JMonrealT/IVESDRIS/RENDER.png

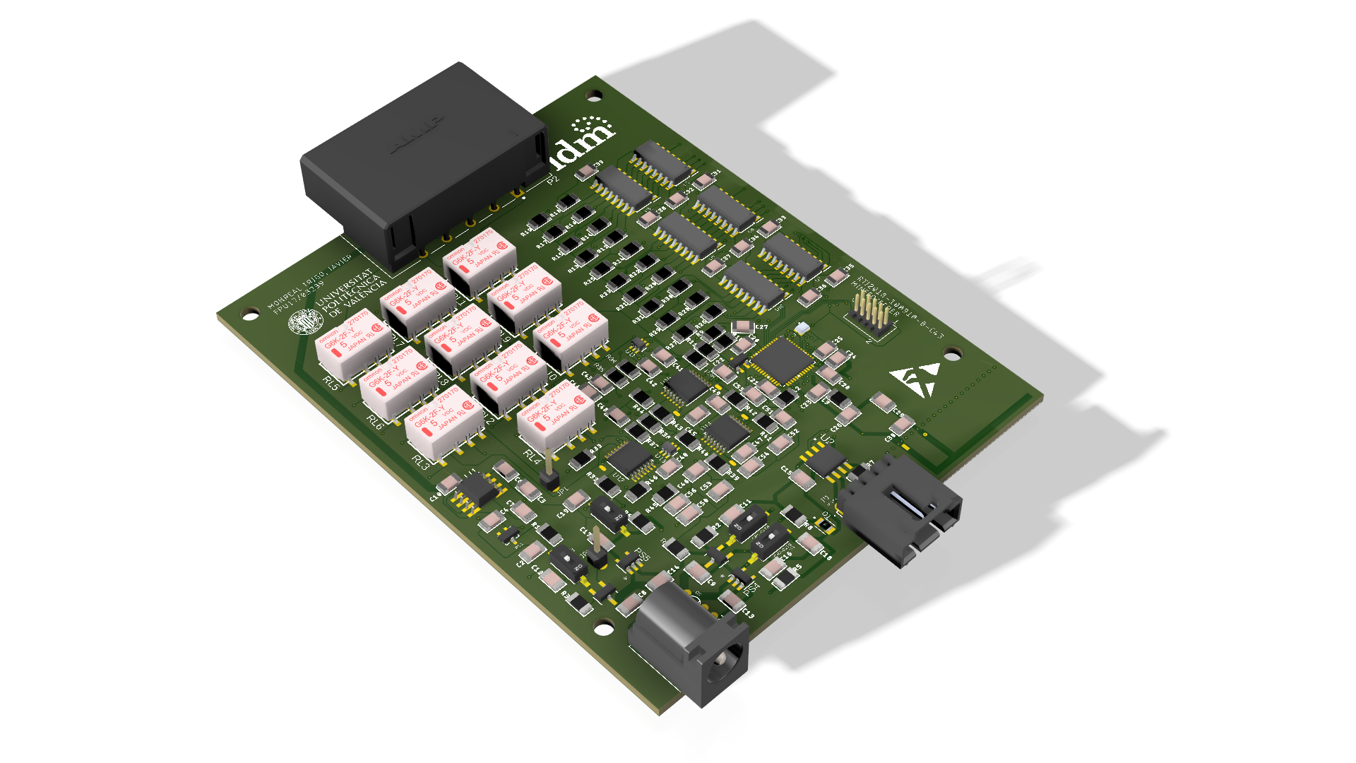
RENDER.png
