JMonrealT/IVESDRIS/Stimulator - Hardware/BoM IVEEDRIS-SCIR.xlsx

Components for ASSEMBLER Eurocircuits
Qty | Value | Device | Package | Parts | Description | DIGIKEY_PRICE-STOCK | HEIGHT | MANUFACTURER_NAME | MANUFACTURER_PART_NUMBER | SUPPLIER_PART_NUMBER
1 |  | ADR5043BKSZ-REEL7KS_3_ADI-M | KS_3_ADI-M | U4 |  |  |  | Analog Devices Inc | ADR5043BKSZ-REEL7
3 |  | CAP_CERAMIC0805 | 805 | C42, C43, C44 | Ceramic Capacitors
10 |  | G6KU-2F-Y | G6KU-2F-Y | RL1, RL2, RL3, RL4, RL5, RL6, RL7, RL8, RL9, RL10 |  | https://www.digikey.com/es/products/detail/omron-electronics-inc-emc-div/G6KU-2F-Y-DC5/1816071 |  | Omron Electronics Inc-EMC Div | G6KU-2F-Y DC5 | Z3303-ND
1 |  | RESISTOR0402 | 402 | R4 | Resistors
1 | 0.0051uH | INDUCTOR0805 | 805 | L3 | Inductors
4 | 0.1u | CAP_CERAMIC0805 | 805 | C22, C24, C25, C27 | Ceramic Capacitors
1 | 0.1uH | INDUCTOR0805 | 805 | L2 | Inductors
2 | 0.7p | CAP_CERAMIC0805 | 805 | C23, C26 | Ceramic Capacitors
1 | 1-316130-2 | 1-316130-2 | TE_1-316130-2 | P2 | CONN HDR 5POS R/A KEY-X 15GOLD | https://www.digikey.com/es/products/detail/te-connectivity-amp-connectors/1-316130-2/664364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 |  | TE Connectivity AMP Connectors | 1-316130-2 | A29616-ND
1 | 100k | RESISTOR1206 | 1206 | R34 | Resistors
17 | 100n | CAP_CERAMIC0805 | 805 | C2, C7, C15, C31, C33, C35, C37, C38, C39, C41, C46, C50, C51, C52, C53, C54, C55 | Ceramic Capacitors
3 | 10k | RESISTOR0805 | 805 | R1, R45, R46 | Resistors
8 | 10n | CAP_CERAMIC0805 | 805 | C4, C6, C10, C16, C17, C40, C45, C47 | Ceramic Capacitors
2 | 10p | CAP_CERAMIC0805 | 805 | C29, C30 | Ceramic Capacitors
4 | 10u | CAP_CERAMIC0805 | 805 | C3, C18, C19, C20 | Ceramic Capacitors
1 | 120 | RESISTOR0805 | 805 | R7 | Resistors
1 | 12k | RESISTOR1206 | 1206 | R36 | Resistors
1 | 12p | CAP_CERAMIC0805 | 805 | C28 | Ceramic Capacitors
2 | 18k | RESISTOR0805 | 805 | R39, R43 | Resistors
1 | 18k | RESISTOR0805 | 805 | R41 | Resistors
1 | 1k | RESISTOR1206 | 1206 | R35 | Resistors
2 | 1m | APSG160ELL102MH20S | CAP_ALUMINIUM | C1, C5 |  | https://www.digikey.com/es/products/detail/united-chemi-con/APSG160ELL102MH20S/5824534 |  | United Chemi-Con | APSG160ELL102MH20S | 565-4311-ND
12 | 1u | CAP_CERAMIC0805 | 805 | C8, C9, C11, C12, C13, C14, C21, C32, C34, C36, C48, C49 | Ceramic Capacitors
1 | 20k | RESISTOR0805 | 805 | R33 | Resistors
1 | 220 | RESISTOR0805 | 805 | R8 | Resistors
1 | 22p | CAP_CERAMIC0805 | 805 | C56 | Ceramic Capacitors
3 | 27k | RESISTOR0805 | 805 | R40, R42, R44 | Resistors
1 | 30k | RESISTOR0805 | 805 | R32 | Resistors
20 | 50 | RESISTOR0805 | 805 | R12, R13, R14, R15, R16, R17, R18, R19, R20, R21, R22, R23, R24, R25, R26, R27, R28, R29, R30, R31 | Resistors
3 | 74HCT238D | 74HCT238D | SOIC127P600X175-16N | U5, U6, U7 | 74HCT238D, Decoder, Demultiplexer HCT, 1-of-8 Non-Inverting 5V 16-Pin SOIC | https://www.digikey.com/es/products/detail/nexperia-usa-inc/74HCT238D652/1023079 | 1.75mm | Nexperia | 74HCT238D,652 | 1727-3389-ND
1 | 820 | RESISTOR0805 | 805 | R11 | Resistors
2 | ADG839 | ADG839 | SC70-6L | U11, U13 | Analog switch. | https://www.digikey.com/es/products/detail/analog-devices-inc/ADG839YKSZ-500RL7/995413 |  | Analog Devices Inc. | ADG839YKSZ-500RL7 | ADG839YKSZ-500RL7TR-ND
4 | CHS-01TB | CHS-01TB | CHS-01TB | S1, S2, S3, S4 |  | https://www.digikey.com/es/products/detail/nidec-copal-electronics/CHS-01TB/948315 |  | Nidec Copal Electronics | CHS-01TB | 563-1004-2-ND
1 | FTSH-105-XX-XX-D | FTSH-105-XX-XX-D | FTSH-105-XX-XX-D | J2 | 0.050X0.050" CL THROUGH HOLE TERMINAL STRIP ASSEMBLY,10 PINS." | https://www.digikey.com/es/products/detail/samtec-inc/FTSH-105-04-F-D/6678180 |  | Samtec | FTSH-105-04-F-D | SAM9443-ND
1 | LM4040DEM3-2.5_NOPB | LM4040DEM3-2.5_NOPB | SOT95P237X112-3N | PS1 |  | https://www.digikey.com/es/products/detail/texas-instruments/LM4040DEM3X-2-5-NOPB/367115 |  | Texas Instruments | LM4040DEM3X-2.5/NOPB | 296-LM4040DEM3X-2.5/NOPBTR-ND
2 | LT1761ES5-3.3TRPBF | LT1761ES5-3.3TRPBF | TSOT-23_S5 | PS4, PS5 |  | https://www.digikey.com/es/products/detail/analog-devices-inc/LT1761ES5-3-3-TRPBF/960258 |  | Linear Technologies | lt1761es5-3.3#trpbf | LT1761ES5-3.3#TRPBFTR-ND
1 | MAX3490ECSA+ | MAX3490ECSA+ | SOIC127P600X175-8N | U2 | Interface IC - transceivers Maxim Integrated MAX3490ECSA+ RS422, RS485 1/1 SOIC 8 N | https://www.digikey.com/es/products/detail/maxim-integrated/MAX3490ECSA-T/1703411 |  | Maxim Integrated | MAX3490ECSA+ | MAX3490ECSA+TTR-ND
2 | MCP1702 | MCP1702 | SOT23-A | PS2, PS3 |  | https://www.digikey.com/es/products/detail/microchip-technology/MCP1702T-2502E-CB/1098467 |  | Microchip Technology | MCP1702T-2502E/CB | MCP1702T-2502E/CBTR-ND
1 | MKW41Z512VHT4 | MKW41Z512VHT4 | LQFN48_7X7 | U3 |  | https://www.digikey.com/es/products/detail/nxp-usa-inc/MKW41Z512VHT4/6073454 |  | NXP | mkw41z512vht4 | MKW41Z512VHT4-ND
1 | MOLEX_SL70400_4-PIN | MOLEX_SL70400_4-PIN | MOLEX_SL70400_4-PIN | P1 |  | https://www.digikey.es/product-detail/es/molex/0705530038/WM4926-ND/313765 |  | Molex | 705530038 | WM4926-ND
3 | OPA4376PW | OPA4376PW | TSSOP14-NOTHERMALPAD | U12, U14, U15
1 | PJ-037A | PJ-037A | CUI_PJ-037A | J1 | 2.0 mm Center Pin, 2.5 A, Right Angle, Through Hole, Dc Power Jack Connector Check prices | https://www.digikey.es/product-detail/es/cui-devices/PJ-037A/CP-037A-ND/1644545 |  | CUI Devices | PJ-037A | CP-037A-ND
1 | SM0805UGC | SM0805UGC | LEDC2012X135N | D1 | LED; SMD; 0805; Ultra Green; 563nm; 10mcd; Water Clear Lens; 130 Deg Viewing Angle | https://www.digikey.es/product-detail/es/bivar-inc/SM0805UGC/492-1329-1-ND/2408561 |  | Bivar Inc. | SM0805UGC | 492-1329-1-ND
1 | TLV2462IDG4 | TLV2462IDG4 | SO8 | U1 |  | https://www.digikey.es/product-detail/es/texas-instruments/TLV2462AQDRQ1/296-17738-1-ND/716923 |  | Texas Instruments | TLV2462AQDRQ1 | 296-17738-1-ND
3 | ULN2003LVDR | ULN2003LVDR | SOIC127P600X175-16N | U8, U9, U10 | 7-Ch Relay, Inductive Sink Driver SOIC16 Texas Instruments ULN2003LVDR, 7-element NPN Darlington Transistor Array, 140 mA 8 V, 16-Pin SOIC | https://www.digikey.es/product-detail/es/texas-instruments/ULN2003LVDR/296-30403-1-ND/3283552 | 1.75mm | Texas Instruments | ULN2003LVDR | 296-30403-1-ND
1 | XRCGB32M000FBH50R0 | XRCGB32M000FBH50R0 | XRCGB32_F | Y1 | MURATA - XRCGB32M000FBH50R0 - CRYSTAL, 32MHZ, 10PF, SMD, 2MM X 1.6MM | https://www.digikey.es/product-detail/es/murata-electronics/XRCGB32M000FBH50R0/490-18345-1-ND/9959807 |  | Murata Electronics | XRCGB32M000FBH50R0 | 490-18345-1-ND
