JMonrealT/IVESDRIS/Stimulator - Enclosure/Ensamblaje.SLDASM

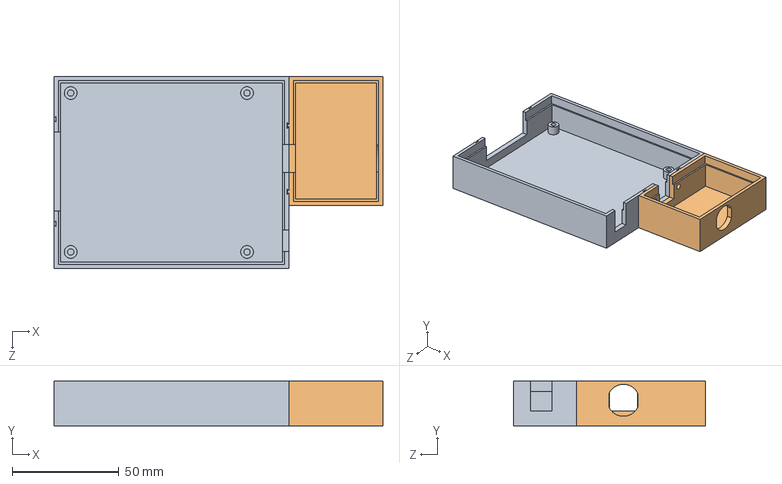
[picture p2: CAD file, 2024-09-23]
Stimulator - Enclosure/Ensamblaje.SLDASM
154.0 x 21.0 x 90.0 mm
Basev2
CommunicationsConnectorBox
