JMonrealT/IVESDRIS/RPi - Enclosure/RPiEnclosure_simple.SLDPRT

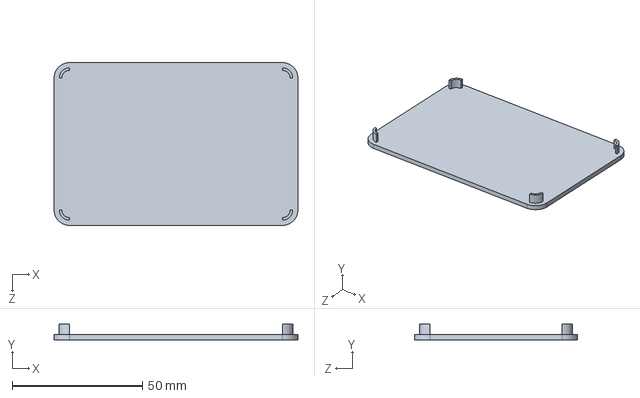
[picture p3: CAD file, 2024-09-23]
RPi - Enclosure/RPiEnclosure_simple.SLDPRT
93.7 x 6.00 x 62.6 mm
