JMonrealT/IVESDRIS/Stimulator - Enclosure/CapsEnclosure.SLDPRT

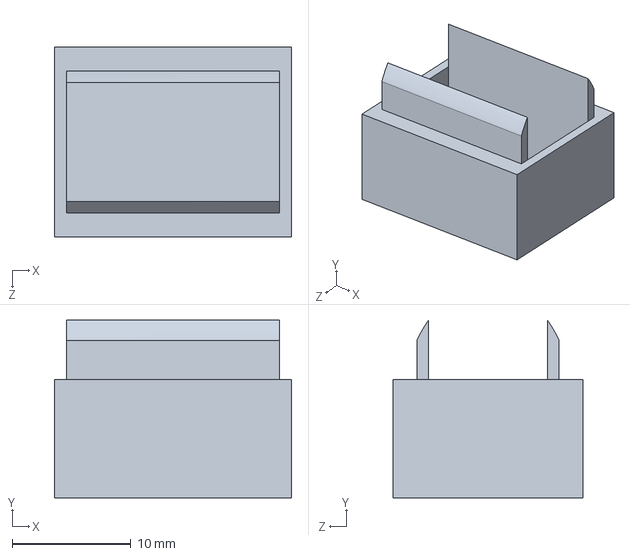
[picture p4: CAD file, 2024-09-23]
Stimulator - Enclosure/CapsEnclosure.SLDPRT
20.0 x 15.0 x 16.0 mm
