JMonrealT/IVESDRIS/RPi - Enclosure/RPiEnclosureTop.SLDPRT

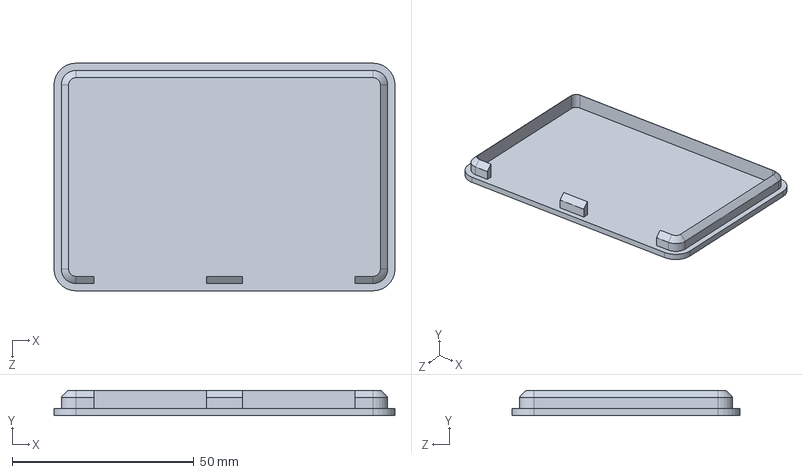
[picture p5: CAD file, 2024-09-23]
RPi - Enclosure/RPiEnclosureTop.SLDPRT
93.7 x 7.00 x 62.6 mm
