JMonrealT/IVESDRIS/Stimulator - Enclosure/Basev2.SLDPRT

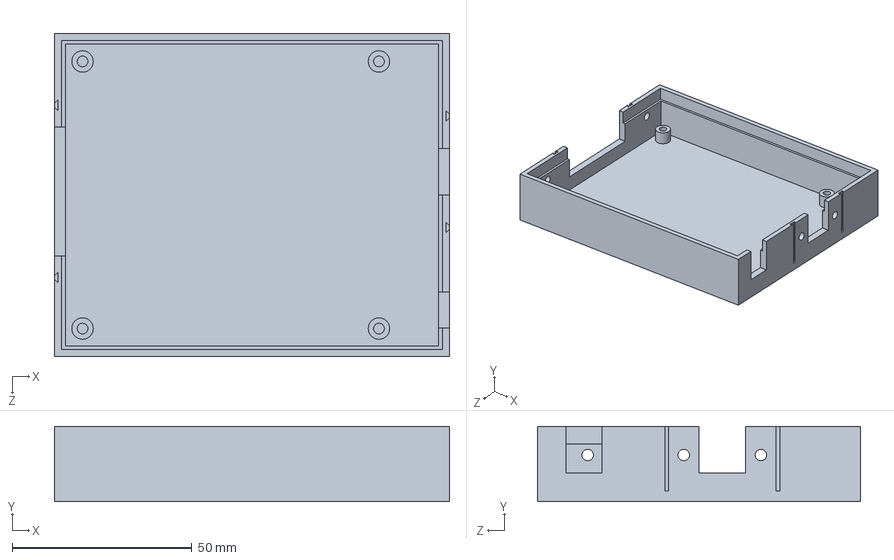
[picture p6: CAD file, 2024-09-23]
Stimulator - Enclosure/Basev2.SLDPRT
110.0 x 21.0 x 90.0 mm
