JMonrealT/IVESDRIS/RPi - Enclosure/RPiEnclosure.SLDPRT

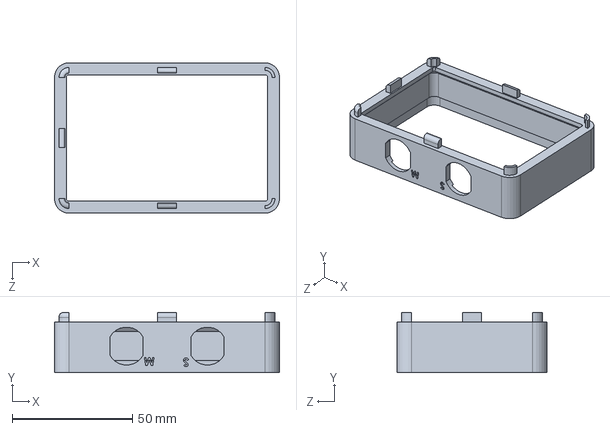
[picture p7: CAD file, 2024-09-23]
RPi - Enclosure/RPiEnclosure.SLDPRT
93.7 x 25.0 x 62.6 mm
