JMonrealT/IVESDRIS/Stimulator - Enclosure/EnclosureCommunications.SLDPRT

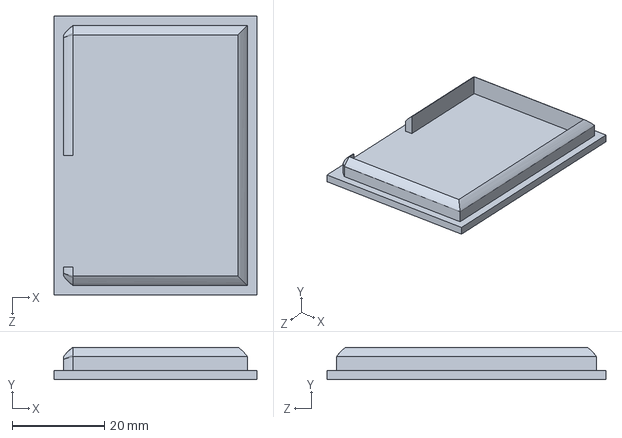
[picture p8: CAD file, 2024-09-23]
Stimulator - Enclosure/EnclosureCommunications.SLDPRT
44.0 x 7.00 x 60.5 mm
