JMonrealT/IVESDRIS/Stimulator - Enclosure/Base.SLDPRT

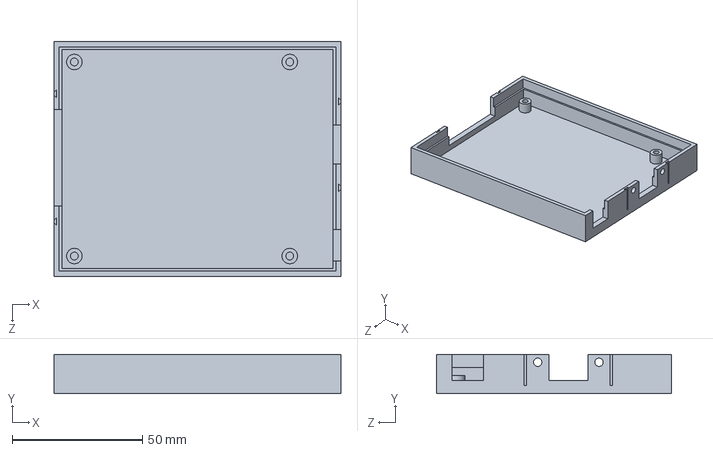
[picture p9: CAD file, 2024-09-23]
Stimulator - Enclosure/Base.SLDPRT
110.0 x 15.0 x 90.0 mm
