JMonrealT/IVESDRIS/Stimulator - Enclosure/EnclosurePrincipal.SLDPRT

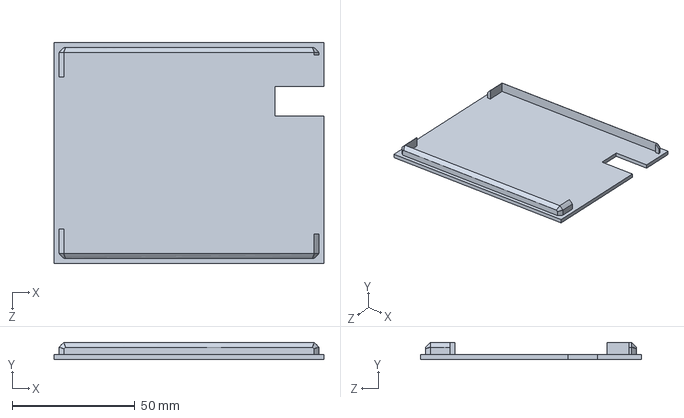
[picture p10: CAD file, 2024-09-23]
Stimulator - Enclosure/EnclosurePrincipal.SLDPRT
110.0 x 7.00 x 90.0 mm
