JMonrealT/IVESDRIS/Stimulator - Enclosure/CommunicationsConnectorBox.SLDPRT

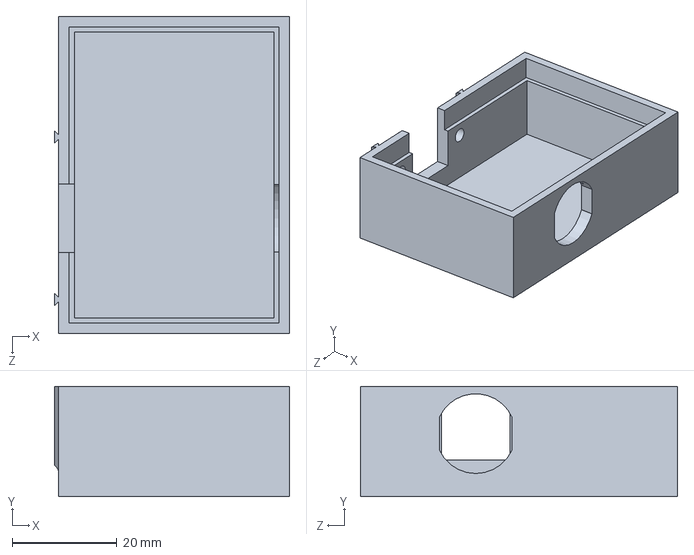
[picture p11: CAD file, 2024-09-23]
Stimulator - Enclosure/CommunicationsConnectorBox.SLDPRT
44.8 x 21.0 x 60.5 mm
