JMonrealT/IVESDRIS/(list of files, cad)

Other CAD files:
RPi - Enclosure/RPiEnclosure.STL
RPi - Enclosure/RPiEnclosureTop.STL
Stimulator - Enclosure/Basev2.STL
Stimulator - Enclosure/CapsEnclosure.STL
Stimulator - Enclosure/CommunicationsConnectorBox.STL
Stimulator - Enclosure/EnclosureCommunications.STL
Stimulator - Enclosure/EnclosurePrincipal.STL
