JMonrealT/IVESDRIS/RPi - Hardware/SCIR RPi COM.brd

## EAGLE design RPi - Hardware/SCIR RPi COM.brd (2024-09-23)

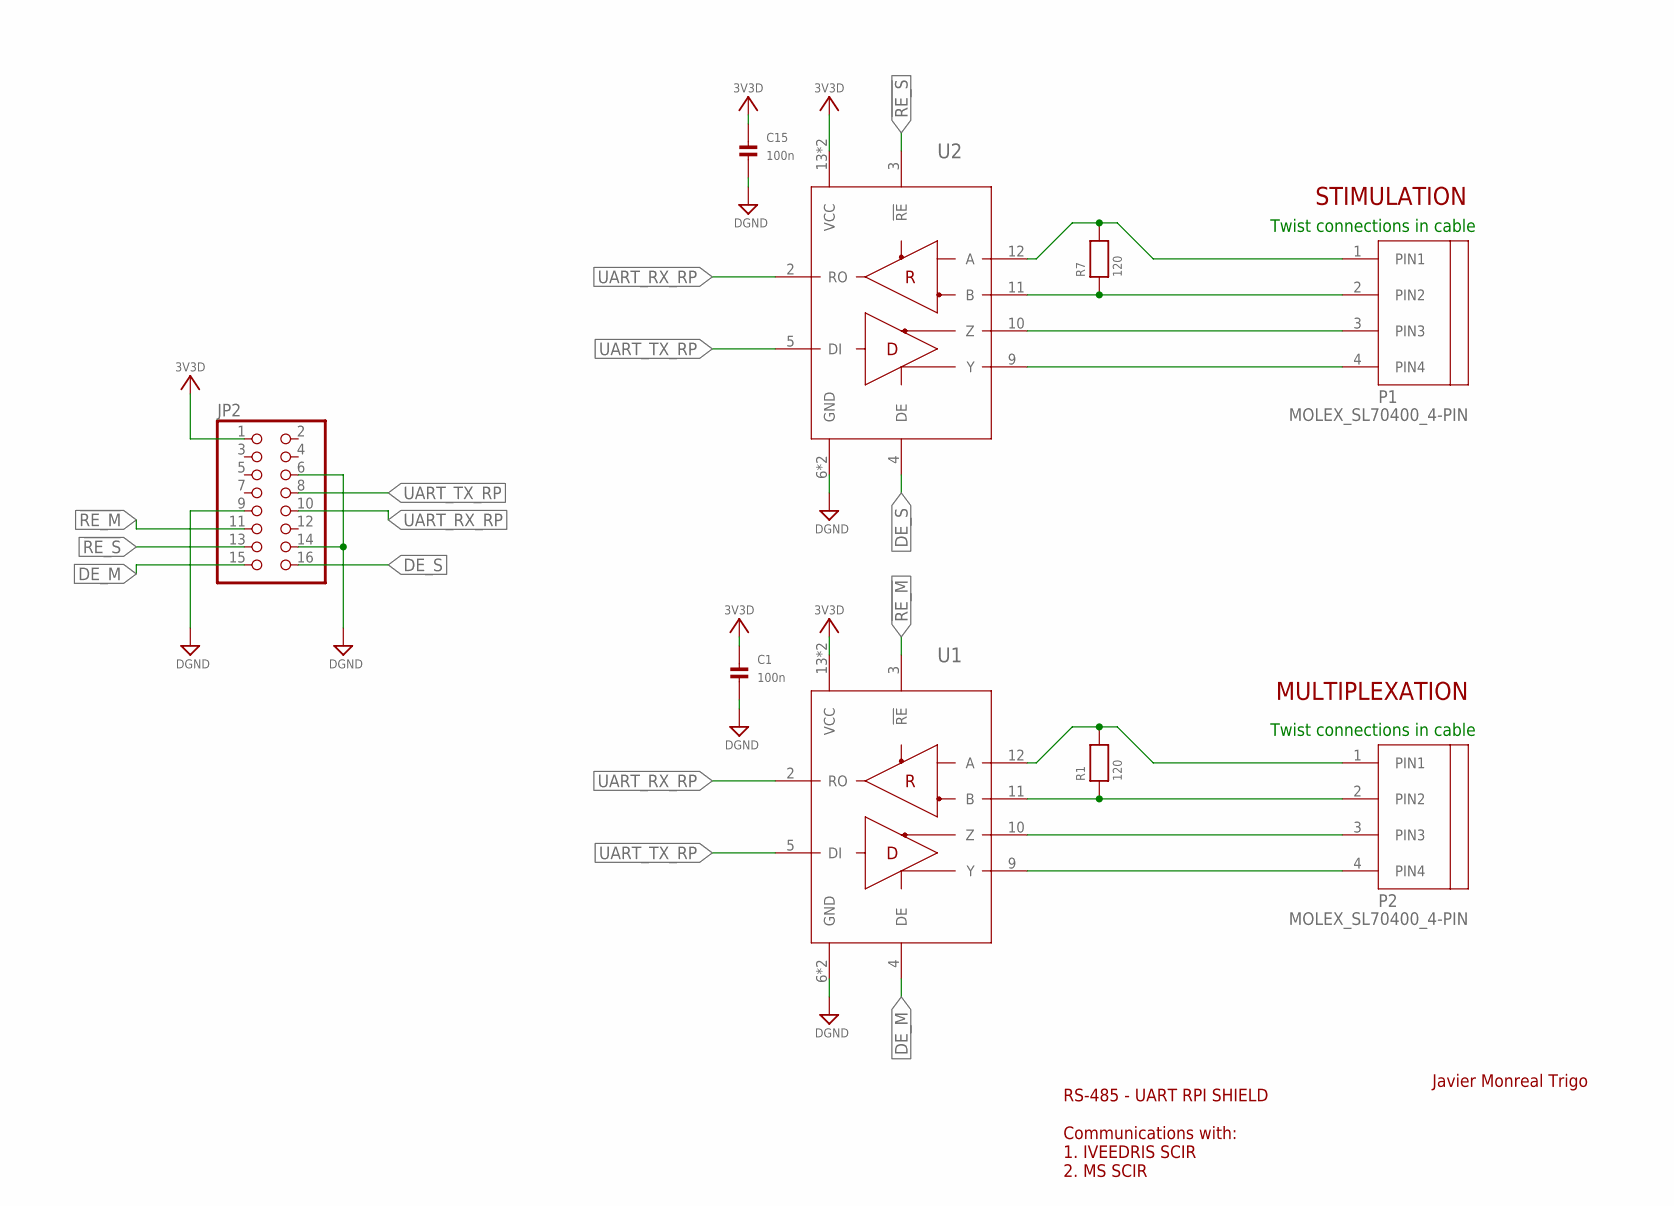
[picture p12: schematic SCIR RPi COM.sch]

Parts:
C1, C15: 100n; 0805
JP2: HEADER-2X8; 2X08
P1, P2: MOLEX_SL70400_4-PIN
R1, R7: 120; 0805
U1, U2: MAX3491ECSD+; SO14

Connections:
3V3D: C1.1, C15.1, JP2.1, U1.13 (VCC), U1.14 (VCC), U2.13 (VCC), U2.14 (VCC)
!RE_M: JP2.11, U1.3 (!RE)
!RE_S: JP2.13, U2.3 (!RE)
DE_M: JP2.15, U1.4 (DE)
DE_S: JP2.16, U2.4 (DE)
DGND: C1.2, C15.2, JP2.6, JP2.9, JP2.14, U1.6 (GND), U1.7 (GND), U2.6 (GND), U2.7 (GND)
unnamed: P1.1 (PIN1), R7.2, U2.12 (A)
unnamed: P2.2 (PIN2), R1.1, U1.11 (B)
unnamed: P1.3 (PIN3), U2.10 (Z)
unnamed: P2.1 (PIN1), R1.2, U1.12 (A)
unnamed: P1.4 (PIN4), U2.9 (Y)
unnamed: P2.4 (PIN4), U1.9 (Y)
unnamed: P2.3 (PIN3), U1.10 (Z)
unnamed: P1.2 (PIN2), R7.1, U2.11 (B)
UART_RX_RP: JP2.10, U1.2 (RO), U2.2 (RO)
UART_TX_RP: JP2.8, U1.5 (DI), U2.5 (DI)

Notes on the sheet:
RS-485 - UART RPI SHIELD Communications with: 1. IVEEDRIS SCIR 2. MS SCIR
Twist connections in cable
Javier Monreal Trigo
STIMULATION
MULTIPLEXATION

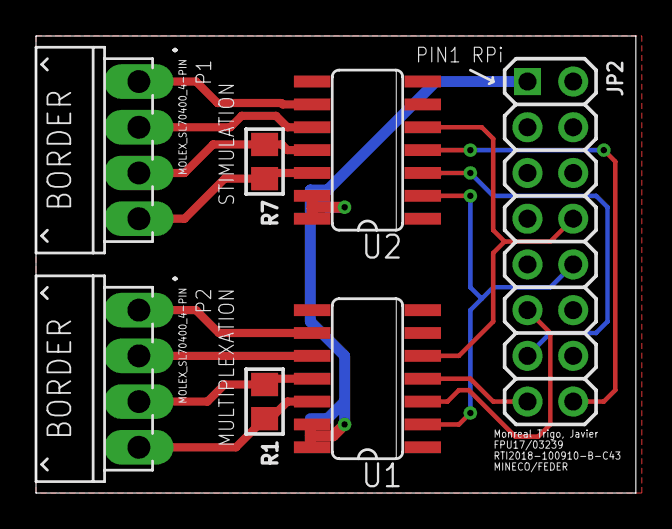
[picture p13: board SCIR RPi COM.brd from above]

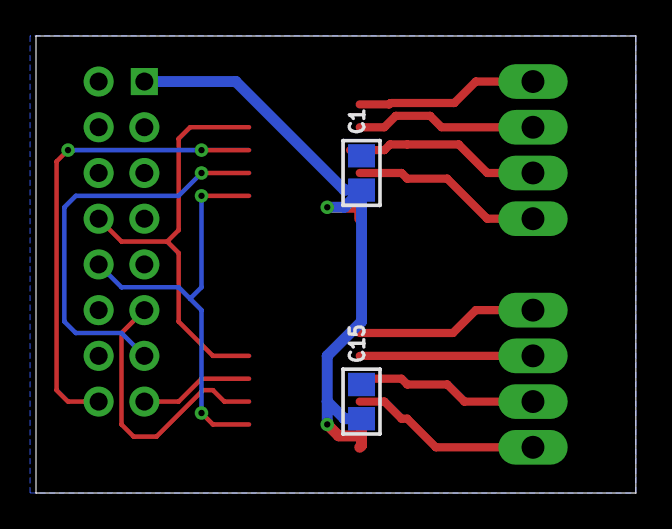
[picture p14: board SCIR RPi COM.brd from below]

Board: 2 copper layers, 33.3 x 25.4 mm, 9 parts (2 on the bottom side), 16 nets.
