JMonrealT/IVESDRIS/Stimulator - Hardware/IVEEDRIS-SCIR.brd

## EAGLE design Stimulator - Hardware/IVEEDRIS-SCIR.brd (2024-09-23)

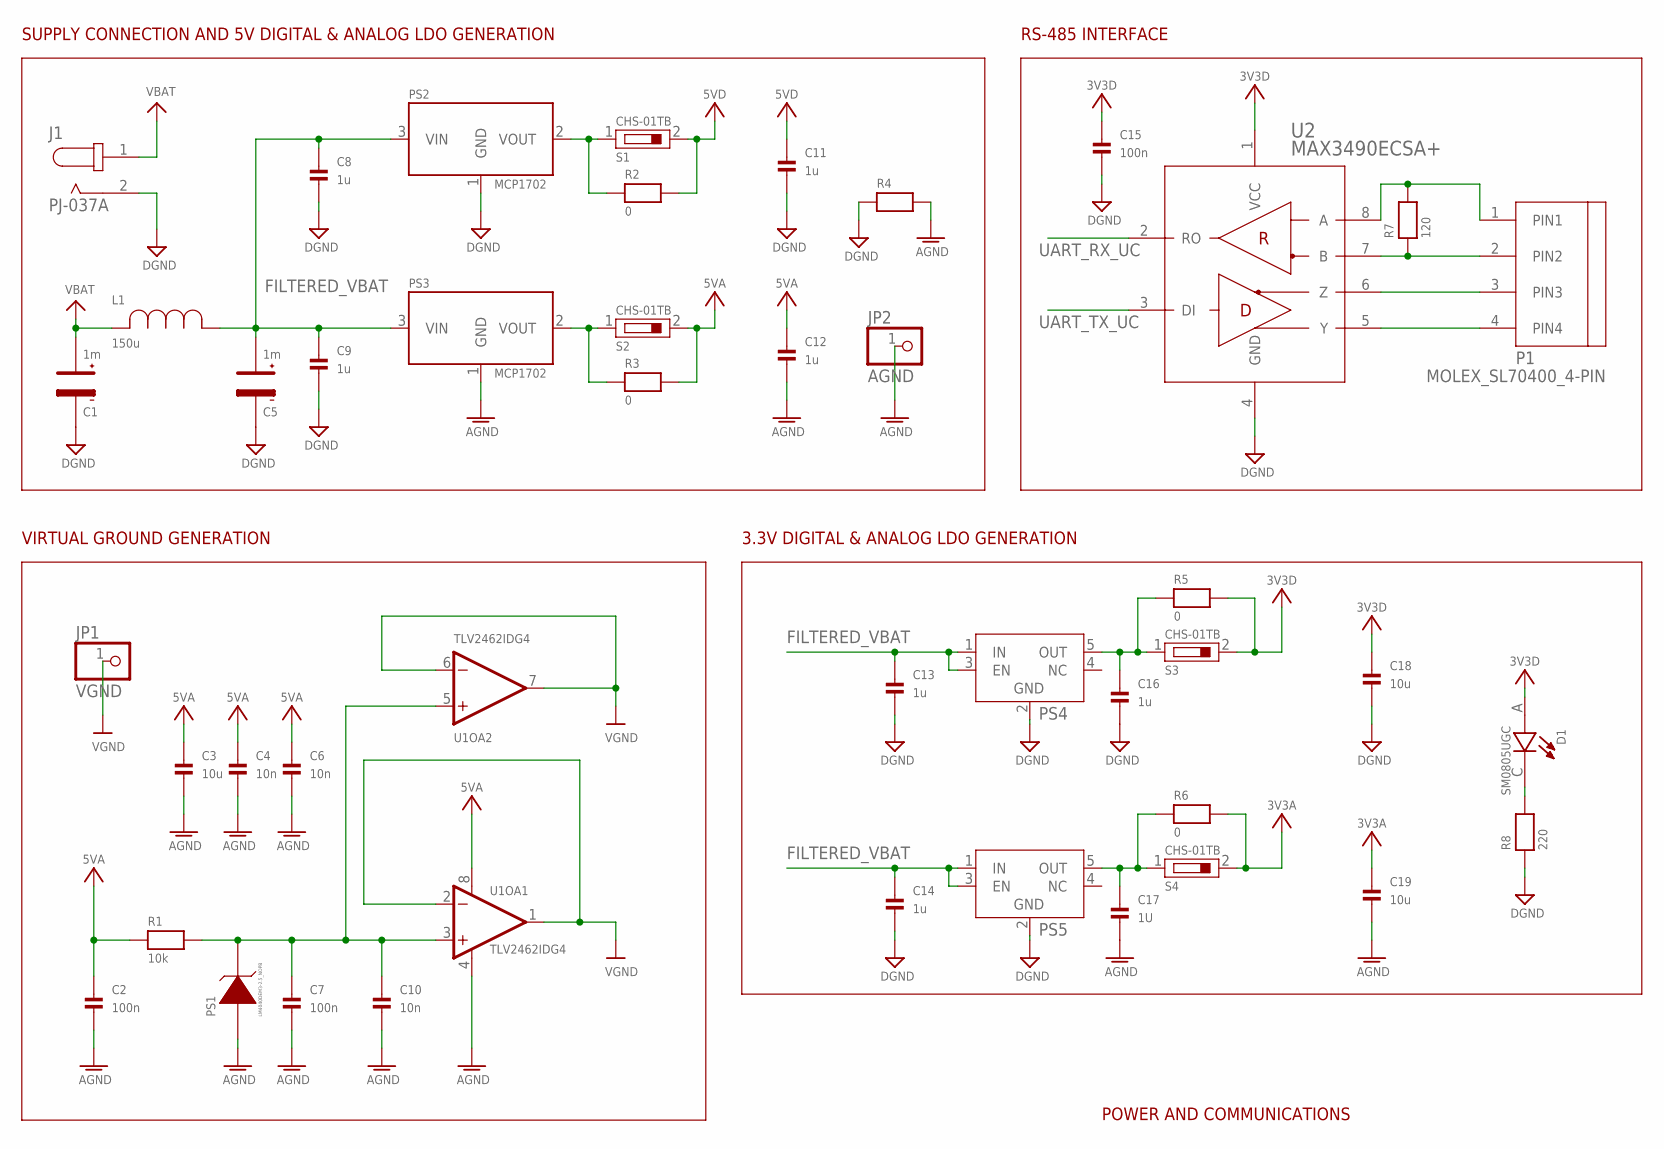
[picture p15: schematic IVEEDRIS-SCIR.sch, sheet 1]

Parts:
C1, C5: 1m; CAP_ALUMINIUM
C2, C7, C15: 100n; 0805
C3, C18, C19: 10u; 0805
C4, C6, C10: 10n; 0805
C8, C9, C11, C12, C13, C14, C16: 1u; 0805
C17: 1U; 0805
D1: SM0805UGC; LEDC2012X135N
J1: PJ-037A; CUI_PJ-037A
JP1: VGND; 1X01_OVAL
JP2: AGND; 1X01_OVAL
L1: 150u; IND_PM3308-RC
P1: MOLEX_SL70400_4-PIN
PS1: LM4040DEM3-2.5_NOPB; SOT95P237X112-3N
PS2, PS3: MCP1702; SOT23-A
PS4, PS5: MCP1802T-3302I/OT; TSOT-23_S5
R1: 10k; 0805
R2, R3, R5, R6: 0; 0805
R4: RESISTOR0402; 0402
R7: 120; 0805
R8: 220; 0805
S1, S2, S3, S4: CHS-01TB
U1: TLV2462IDG4; SO8
U2: MAX3490ECSA+; SOIC127P600X175-8N

Connections:
3V3A: C19.1, R6.2, S4.2; also elsewhere on the board
3V3D: C15.1, C18.1, D1.A, R5.2, S3.2, U2.1 (VCC); also elsewhere on the board
5VA: C2.1, C3.1, C4.1, C6.1, C12.1, R1.1, R3.2, S2.2, U1.8 (V+); also elsewhere on the board
5VD: C11.1, R2.2, S1.2; also elsewhere on the board
AGND: C2.2, C3.2, C4.2, C6.2, C7.2, C10.2, C12.2, C17.2, C19.2, JP2.1, PS1.2 (ANODE), PS3.1 (GND), R4.2, U1.4 (V-); also elsewhere on the board
DGND: C1.2, C5.2, C8.2, C9.2, C11.2, C13.2, C14.2, C15.2, C16.2, C18.2, J1.2, PS2.1 (GND), PS4.2 (GND), PS5.2 (GND), R4.1, R8.1, U2.4 (GND); also elsewhere on the board
FILTERED_VBAT: C5.1, C8.1, C9.1, C13.1, C14.1, L1.1, PS2.3 (VIN), PS3.3 (VIN), PS4.1 (IN), PS4.3 (EN), PS5.1 (IN), PS5.3 (EN)
unnamed: PS3.2 (VOUT), R3.1, S2.1
unnamed: P1.4 (PIN4), U2.5 (Y)
unnamed: C7.1, C10.1, PS1.1 (CATHODE), R1.2, U1.3 (+IN), U1.5 (+IN)
unnamed: PS2.2 (VOUT), R2.1, S1.1
unnamed: P1.3 (PIN3), U2.6 (Z)
unnamed: C17.1, PS5.5 (OUT), R6.1, S4.1
unnamed: C16.1, PS4.5 (OUT), R5.1, S3.1
unnamed: D1.C, R8.2
unnamed: P1.2 (PIN2), R7.1, U2.7 (B)
unnamed: P1.1 (PIN1), R7.2, U2.8 (A)
UART_RX_UC: U2.2 (RO); also elsewhere on the board
UART_TX_UC: U2.3 (DI); also elsewhere on the board
VBAT: C1.1, J1.1, L1.2
VGND: JP1.1, U1.1 (OUT), U1.2 (-IN), U1.6 (-IN), U1.7 (OUT); also elsewhere on the board

Notes on the sheet:
POWER AND COMMUNICATIONS
SUPPLY CONNECTION AND 5V DIGITAL & ANALOG LDO GENERATION
VIRTUAL GROUND GENERATION
3.3V DIGITAL & ANALOG LDO GENERATION
RS-485 INTERFACE

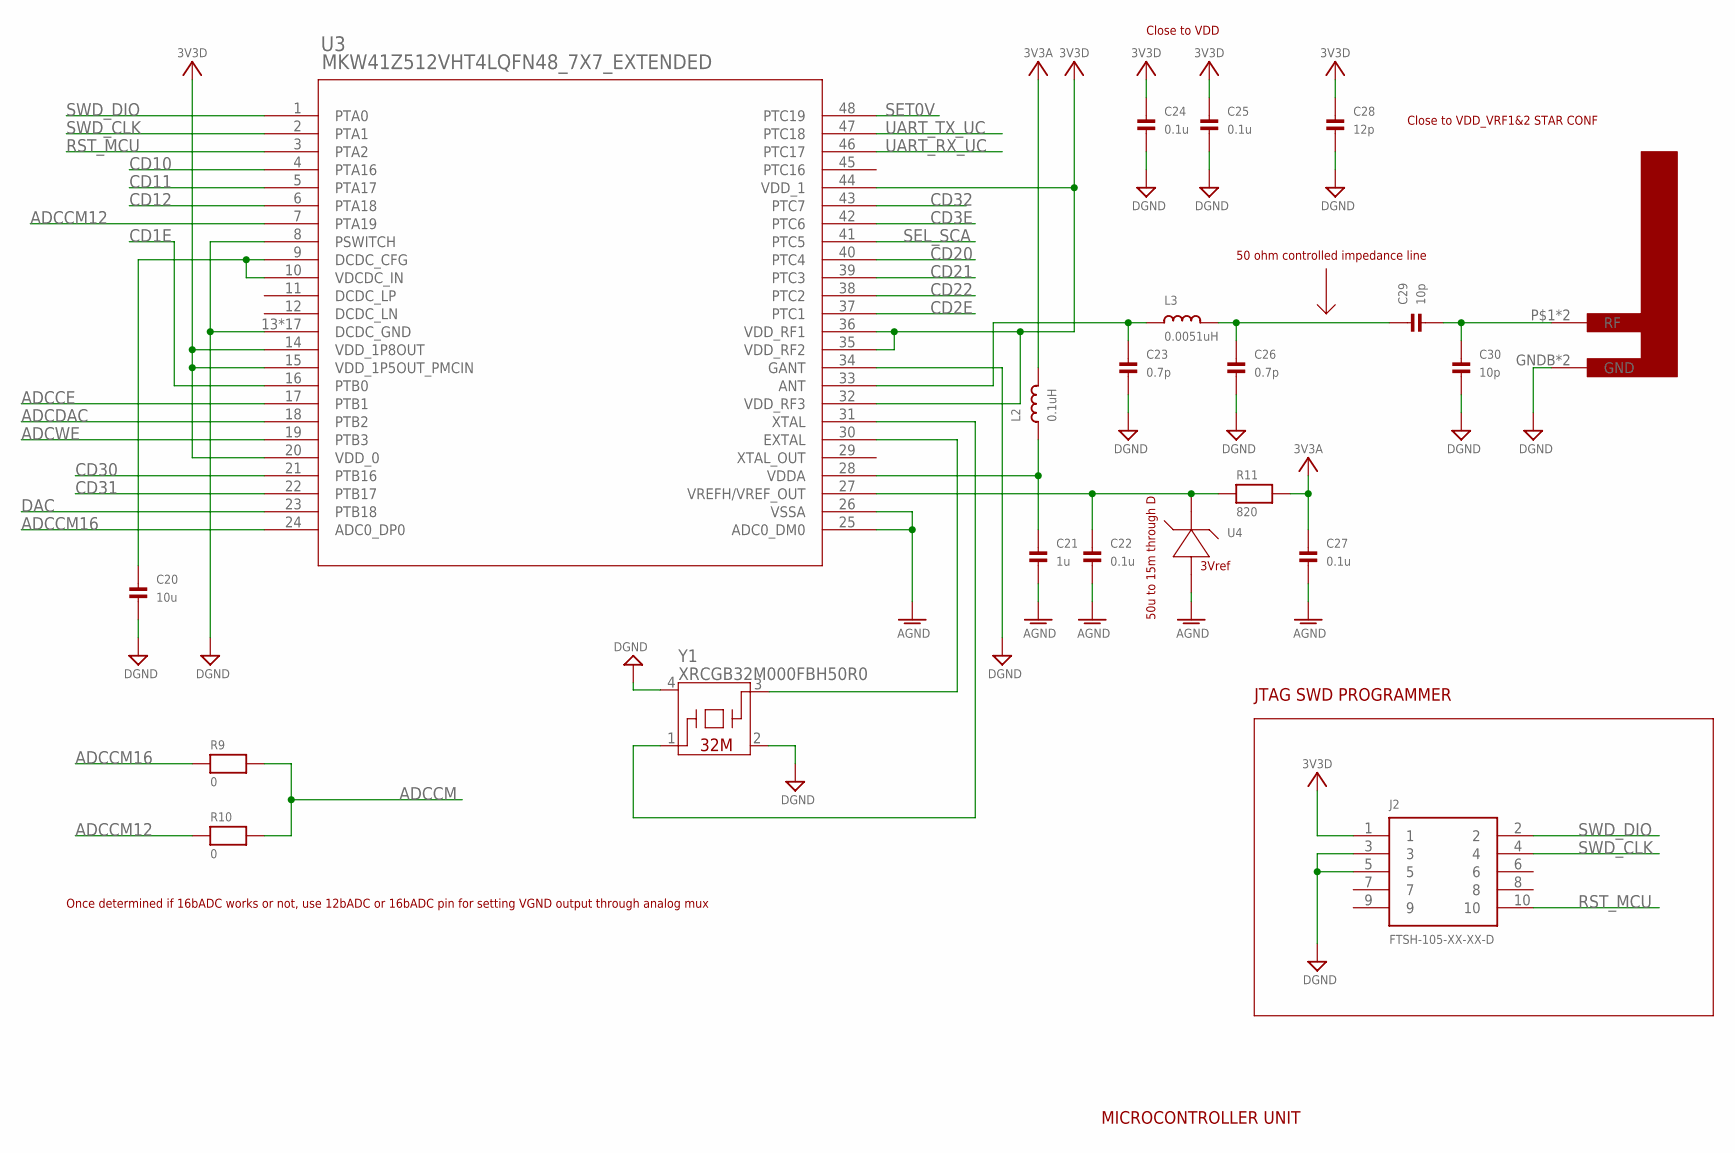
[picture p16: schematic IVEEDRIS-SCIR.sch, sheet 2]

Parts:
AE1: F_INVERTED_ANTENNA_2.4G; RF2.4GHZ_FINVERTED_ANTENNA
C20: 10u; 0805
C21: 1u; 0805
C22, C24, C25, C27: 0.1u; 0805
C23, C26: 0.7p; 0805
C28: 12p; 0805
C29, C30: 10p; 0805
J2: FTSH-105-XX-XX-D
L2: 0.1uH; 0805
L3: 0.0051uH; 0805
R9, R10: 0; 0805
R11: 820; 0805
U3: MKW41Z512VHT4LQFN48_7X7_EXTENDED; LQFN48_7X7_EXTENDED
U4: ADR5043BKSZ-REEL7KS_3_ADI-M; KS_3_ADI-M
Y1: XRCGB32M000FBH50R0; XRCGB32_F

Connections:
3V3A: C27.1, L2.2, R11.2; also elsewhere on the board
3V3D: C24.1, C25.1, C28.1, J2.1, U3.14 (VDD_1P8OUT), U3.15 (VDD_1P5OUT_PMCIN), U3.20 (VDD_0), U3.32 (VDD_RF3), U3.35 (VDD_RF2), U3.36 (VDD_RF1), U3.44 (VDD_1); also elsewhere on the board
ADCCE: U3.17 (PTB1); also elsewhere on the board
ADCCM: R9.2, R10.2; also elsewhere on the board
ADCCM12: R10.1, U3.7 (PTA19)
ADCCM16: R9.1, U3.24 (ADC0_DP0)
ADCDAC: U3.18 (PTB2); also elsewhere on the board
ADCWE: U3.19 (PTB3); also elsewhere on the board
AGND: C21.2, C22.2, C27.2, U3.25 (ADC0_DM0), U3.26 (VSSA), U4.2 (V-); also elsewhere on the board
CD1E: U3.16 (PTB0); also elsewhere on the board
CD2E: U3.37 (PTC1); also elsewhere on the board
CD3E: U3.42 (PTC6); also elsewhere on the board
CD10: U3.4 (PTA16); also elsewhere on the board
CD11: U3.5 (PTA17); also elsewhere on the board
CD12: U3.6 (PTA18); also elsewhere on the board
CD20: U3.40 (PTC4); also elsewhere on the board
CD21: U3.39 (PTC3); also elsewhere on the board
CD22: U3.38 (PTC2); also elsewhere on the board
CD30: U3.21 (PTB16); also elsewhere on the board
CD31: U3.22 (PTB17); also elsewhere on the board
CD32: U3.43 (PTC7); also elsewhere on the board
DAC: U3.23 (PTB18); also elsewhere on the board
DGND: AE1.GNDB (GND), AE1.GNDT (GND), C20.2, C23.2, C24.2, C25.2, C26.2, C28.2, C30.2, J2.3, J2.5, U3.8 (PSWITCH), U3.13 (DCDC_GND), U3.34 (GANT), U3.49 (DCDC_GND), U3.50 (DCDC_GND), U3.51 (DCDC_GND), U3.52 (DCDC_GND), U3.53 (DCDC_GND), U3.54 (DCDC_GND), U3.55 (DCDC_GND), U3.56 (DCDC_GND), U3.57 (DCDC_GND), U3.58 (DCDC_GND), U3.59 (DCDC_GND), U3.60 (DCDC_GND), U3.61 (DCDC_GND), U3.62 (DCDC_GND), U3.63 (DCDC_GND), U3.64 (DCDC_GND), Y1.2 (NC_1), Y1.4 (NC_2); also elsewhere on the board
unnamed: C21.1, L2.1, U3.28 (VDDA)
unnamed: C20.1, U3.9 (DCDC_CFG), U3.10 (VDCDC_IN)
unnamed: C22.1, R11.1, U3.27 (VREFH/VREF_OUT), U4.1 (V+)
unnamed: U3.31 (XTAL), Y1.1 (CRYSTAL_1)
unnamed: U3.30 (EXTAL), Y1.3 (CRYSTAL_2)
unnamed: C23.1, L3.1, U3.33 (ANT)
unnamed: C26.1, C29.1, L3.2
unnamed: AE1.P$1 (RF), AE1.RF, C29.2, C30.1
RST_MCU: J2.10, U3.3 (PTA2)
SEL_SCA: U3.41 (PTC5); also elsewhere on the board
SET0V: U3.48 (PTC19); also elsewhere on the board
SWD_CLK: J2.4, U3.2 (PTA1)
SWD_DIO: J2.2, U3.1 (PTA0)
UART_RX_UC: U3.46 (PTC17); also elsewhere on the board
UART_TX_UC: U3.47 (PTC18); also elsewhere on the board

Notes on the sheet:
MICROCONTROLLER UNIT
50 ohm controlled impedance line
Close to VDD
Close to VDD_VRF1&2 STAR CONF
Once determined if 16bADC works or not, use 12bADC or 16bADC pin for setting VGND output through analog mux
JTAG SWD PROGRAMMER
50u to 15m through D

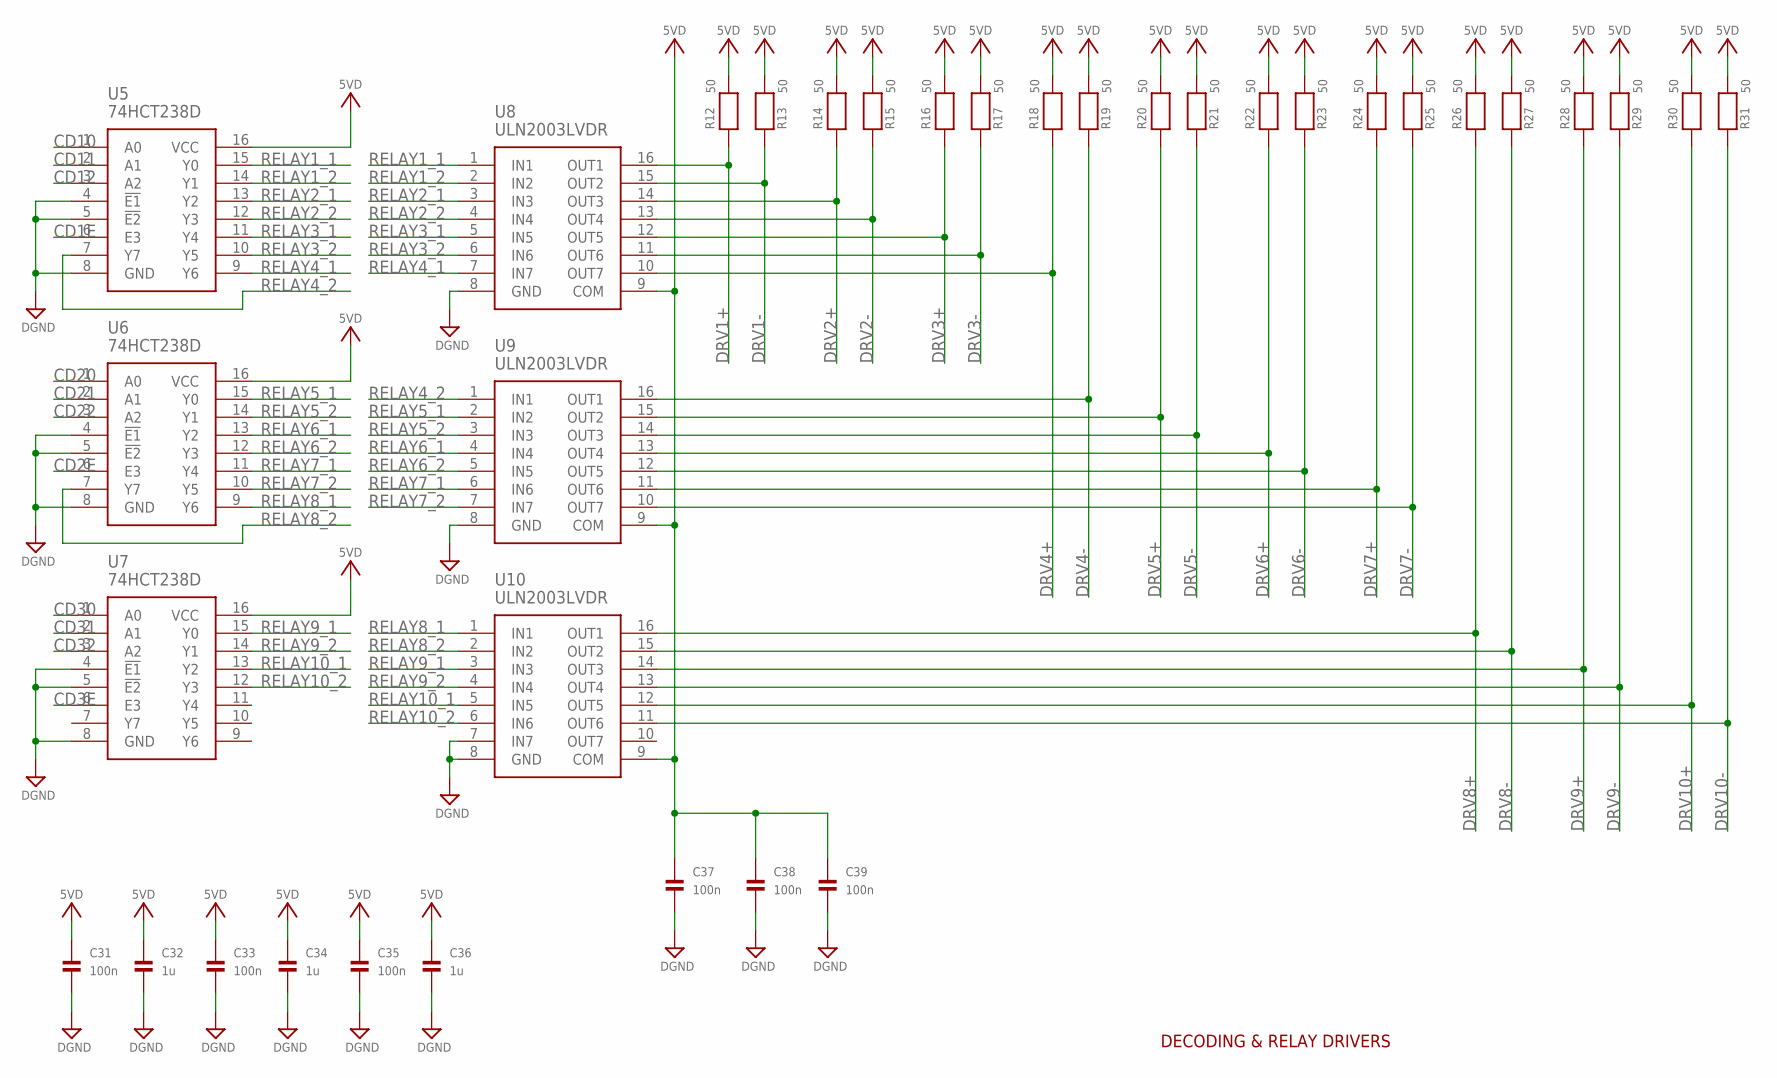
[picture p17: schematic IVEEDRIS-SCIR.sch, sheet 3]

Parts:
C31, C33, C35, C37, C38, C39: 100n; 0805
C32, C34, C36: 1u; 0805
R12, R13, R14, R15, R16, R17, R18, R19, R20, R21, R22, R23, R24, R25, R26, R27, R28, R29, R30, R31: 50; 0805
U5, U6, U7: 74HCT238D; SOIC127P600X175-16N
U8, U9, U10: ULN2003LVDR; SOIC127P600X175-16N

Connections:
5VD: C31.1, C32.1, C33.1, C34.1, C35.1, C36.1, C37.1, C38.1, C39.1, R12.2, R13.2, R14.2, R15.2, R16.2, R17.2, R18.2, R19.2, R20.2, R21.2, R22.2, R23.2, R24.2, R25.2, R26.2, R27.2, R28.2, R29.2, R30.2, R31.2, U5.16 (VCC), U6.16 (VCC), U7.16 (VCC), U8.9 (COM), U9.9 (COM), U10.9 (COM); also elsewhere on the board
CD1E: U5.6 (E3); also elsewhere on the board
CD2E: U6.6 (E3); also elsewhere on the board
CD3E: U7.6 (E3); also elsewhere on the board
CD10: U5.1 (A0); also elsewhere on the board
CD11: U5.2 (A1); also elsewhere on the board
CD12: U5.3 (A2); also elsewhere on the board
CD20: U6.1 (A0); also elsewhere on the board
CD21: U6.2 (A1); also elsewhere on the board
CD22: U6.3 (A2); also elsewhere on the board
CD30: U7.1 (A0); also elsewhere on the board
CD31: U7.2 (A1); also elsewhere on the board
CD32: U7.3 (A2); also elsewhere on the board
DGND: C31.2, C32.2, C33.2, C34.2, C35.2, C36.2, C37.2, C38.2, C39.2, U5.4 (!E1), U5.5 (!E2), U5.8 (GND), U6.4 (!E1), U6.5 (!E2), U6.8 (GND), U7.4 (!E1), U7.5 (!E2), U7.8 (GND), U8.8 (GND), U9.8 (GND), U10.7 (IN7), U10.8 (GND); also elsewhere on the board
DRV1+: R12.1, U8.16 (OUT1); also elsewhere on the board
DRV1-: R13.1, U8.15 (OUT2); also elsewhere on the board
DRV2+: R14.1, U8.14 (OUT3); also elsewhere on the board
DRV2-: R15.1, U8.13 (OUT4); also elsewhere on the board
DRV3+: R16.1, U8.12 (OUT5); also elsewhere on the board
DRV3-: R17.1, U8.11 (OUT6); also elsewhere on the board
DRV4+: R18.1, U8.10 (OUT7); also elsewhere on the board
DRV4-: R19.1, U9.16 (OUT1); also elsewhere on the board
DRV5+: R20.1, U9.15 (OUT2); also elsewhere on the board
DRV5-: R21.1, U9.14 (OUT3); also elsewhere on the board
DRV6+: R22.1, U9.13 (OUT4); also elsewhere on the board
DRV6-: R23.1, U9.12 (OUT5); also elsewhere on the board
DRV7+: R24.1, U9.11 (OUT6); also elsewhere on the board
DRV7-: R25.1, U9.10 (OUT7); also elsewhere on the board
DRV8+: R26.1, U10.16 (OUT1); also elsewhere on the board
DRV8-: R27.1, U10.15 (OUT2); also elsewhere on the board
DRV9+: R28.1, U10.14 (OUT3); also elsewhere on the board
DRV9-: R29.1, U10.13 (OUT4); also elsewhere on the board
DRV10+: R30.1, U10.12 (OUT5); also elsewhere on the board
DRV10-: R31.1, U10.11 (OUT6); also elsewhere on the board
RELAY1_1: U5.15 (Y0), U8.1 (IN1)
RELAY1_2: U5.14 (Y1), U8.2 (IN2)
RELAY2_1: U5.13 (Y2), U8.3 (IN3)
RELAY2_2: U5.12 (Y3), U8.4 (IN4)
RELAY3_1: U5.11 (Y4), U8.5 (IN5)
RELAY3_2: U5.10 (Y5), U8.6 (IN6)
RELAY4_1: U5.9 (Y6), U8.7 (IN7)
RELAY4_2: U5.7 (Y7), U9.1 (IN1)
RELAY5_1: U6.15 (Y0), U9.2 (IN2)
RELAY5_2: U6.14 (Y1), U9.3 (IN3)
RELAY6_1: U6.13 (Y2), U9.4 (IN4)
RELAY6_2: U6.12 (Y3), U9.5 (IN5)
RELAY7_1: U6.11 (Y4), U9.6 (IN6)
RELAY7_2: U6.10 (Y5), U9.7 (IN7)
RELAY8_1: U6.9 (Y6), U10.1 (IN1)
RELAY8_2: U6.7 (Y7), U10.2 (IN2)
RELAY9_1: U7.15 (Y0), U10.3 (IN3)
RELAY9_2: U7.14 (Y1), U10.4 (IN4)
RELAY10_1: U7.13 (Y2), U10.5 (IN5)
RELAY10_2: U7.12 (Y3), U10.6 (IN6)

Notes on the sheet:
DECODING & RELAY DRIVERS

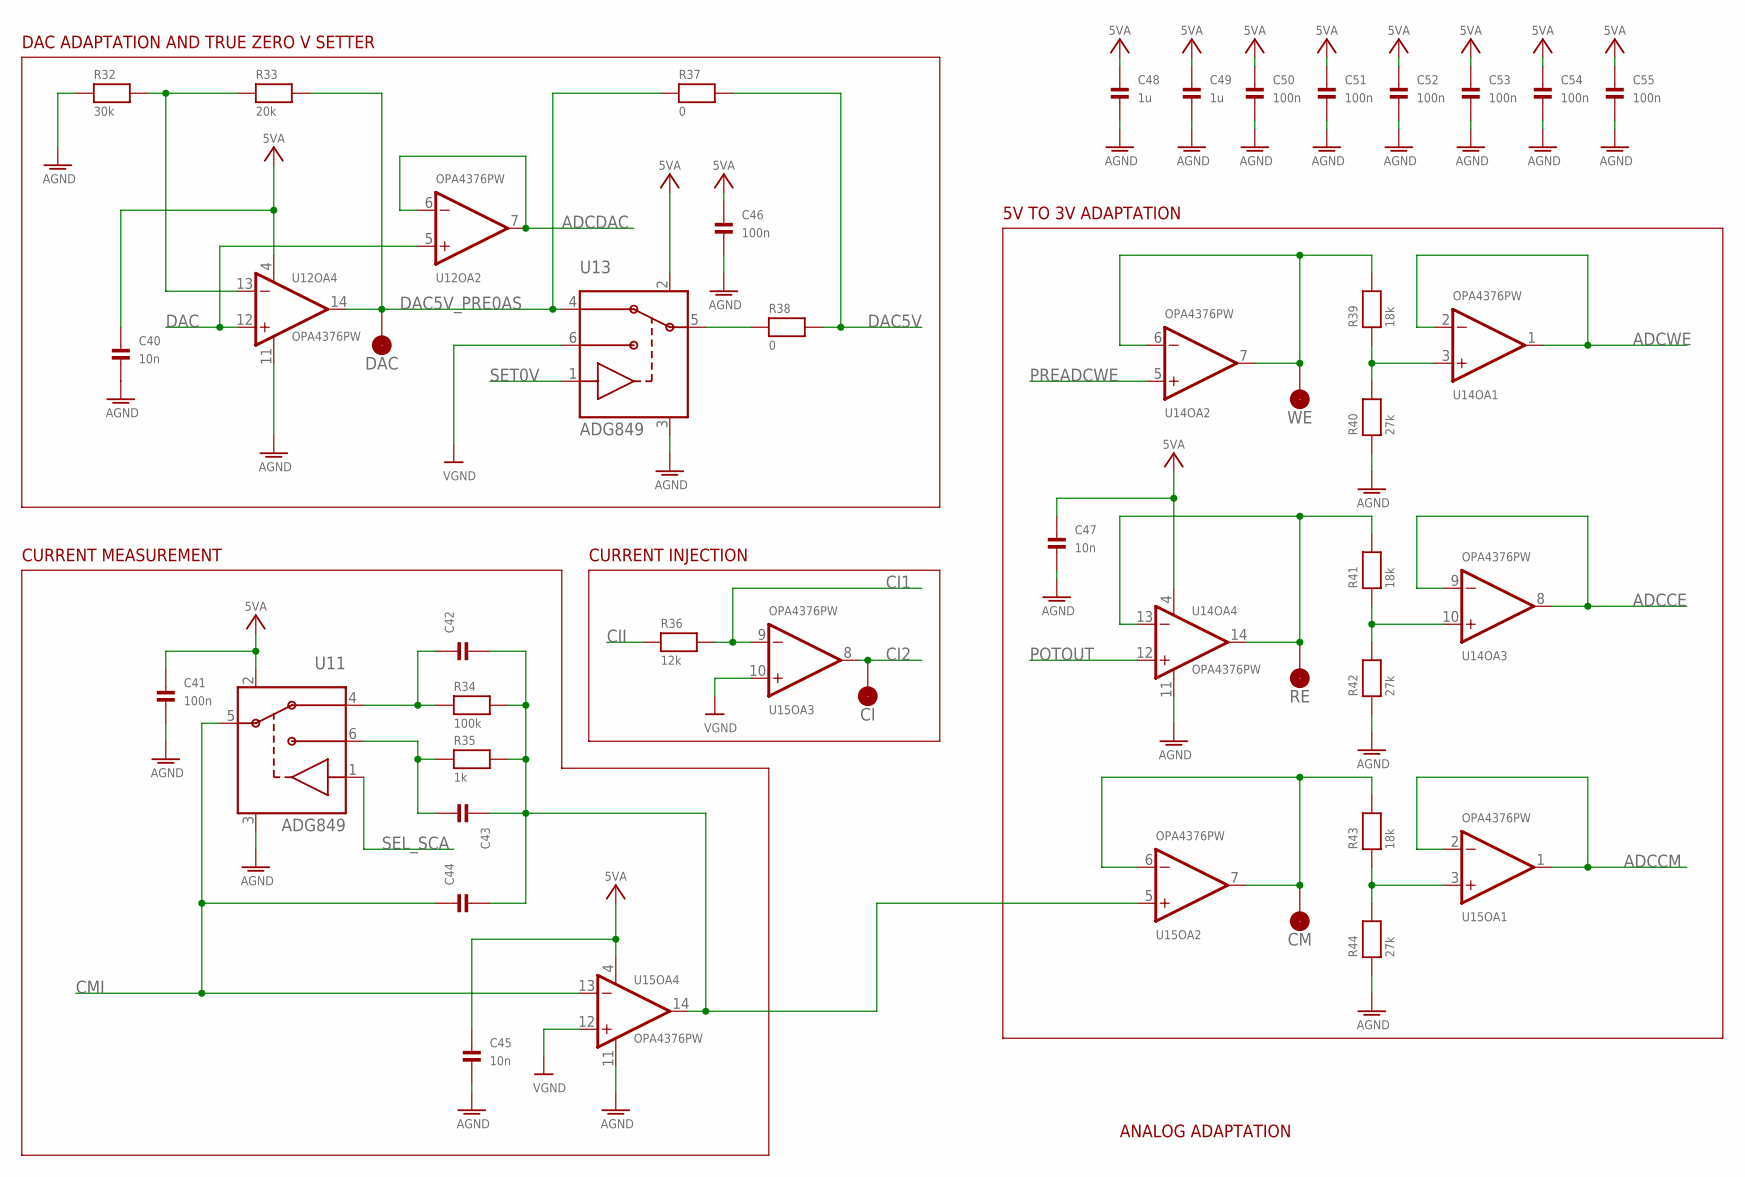
[picture p18: schematic IVEEDRIS-SCIR.sch, sheet 4]

Parts:
C40, C45, C47: 10n; 0805
C41, C46, C50, C51, C52, C53, C54, C55: 100n; 0805
C42, C43, C44: CAP_CERAMIC0805; 0805
C48, C49: 1u; 0805
CI: TESTPOINT; NOSOLDERPAD
CM: TESTPOINT; NOSOLDERPAD
DAC: TESTPOINT; NOSOLDERPAD
R32: 30k; 0805
R33: 20k; 0805
R34: 100k; 1206
R35: 1k; 1206
R36: 12k; 1206
R37, R38: 0; 0805
R39, R41, R43: 18k; 0805
R40, R42, R44: 27k; 0805
RE: TESTPOINT; NOSOLDERPAD
U11, U13: ADG849; SC70-6L
U12, U14, U15: OPA4376PW; TSSOP14-NOTHERMALPAD
WE: TESTPOINT; NOSOLDERPAD

Connections:
5VA: C40.1, C41.1, C45.1, C46.1, C47.1, C48.1, C49.1, C50.1, C51.1, C52.1, C53.1, C54.1, C55.1, U11.2 (VDD), U12.4 (V+), U13.2 (VDD), U14.4 (V+), U15.4 (V+); also elsewhere on the board
ADCCE: U14.8 (OUT), U14.9 (-IN); also elsewhere on the board
ADCCM: U15.1 (OUT), U15.2 (-IN); also elsewhere on the board
ADCDAC: U12.6 (-IN), U12.7 (OUT); also elsewhere on the board
ADCWE: U14.1 (OUT), U14.2 (-IN); also elsewhere on the board
AGND: C40.2, C41.2, C45.2, C46.2, C47.2, C48.2, C49.2, C50.2, C51.2, C52.2, C53.2, C54.2, C55.2, R32.1, R40.1, R42.1, R44.1, U11.3 (GND), U12.11 (V-), U13.3 (GND), U14.11 (V-), U15.11 (V-); also elsewhere on the board
CI1: R36.2, U15.9 (-IN); also elsewhere on the board
CI2: CI.P$1, U15.8 (OUT); also elsewhere on the board
CII: R36.1; also elsewhere on the board
CMI: C44.1, U11.5 (D), U15.13 (-IN); also elsewhere on the board
DAC: U12.5 (+IN), U12.12 (+IN); also elsewhere on the board
DAC5V: R37.2, R38.2; also elsewhere on the board
DAC5V_PRE0AS: DAC.P$1, R33.2, R37.1, U12.14 (OUT), U13.4 (S1)
HHHHH: C42.2, C43.2, C44.2, R34.2, R35.2, U15.5 (+IN), U15.14 (OUT)
unnamed: R38.1, U13.5 (D)
unnamed: R41.1, R42.2, U14.10 (+IN)
unnamed: R43.1, R44.2, U15.3 (+IN)
unnamed: R41.2, RE.P$1, U14.13 (-IN), U14.14 (OUT)
unnamed: R39.1, R40.2, U14.3 (+IN)
unnamed: R39.2, U14.6 (-IN), U14.7 (OUT), WE.P$1
unnamed: CM.P$1, R43.2, U15.6 (-IN), U15.7 (OUT)
unnamed: R32.2, R33.1, U12.13 (-IN)
unnamed: C42.1, R34.1, U11.4 (S1)
unnamed: C43.1, R35.1, U11.6 (S2)
POTOUT: U14.12 (+IN); also elsewhere on the board
PREADCWE: U14.5 (+IN); also elsewhere on the board
SEL_SCA: U11.1 (IN); also elsewhere on the board
SET0V: U13.1 (IN); also elsewhere on the board
VGND: U13.6 (S2), U15.10 (+IN), U15.12 (+IN); also elsewhere on the board

Notes on the sheet:
CURRENT MEASUREMENT
DAC ADAPTATION AND TRUE ZERO V SETTER
CURRENT INJECTION
ANALOG ADAPTATION
5V TO 3V ADAPTATION

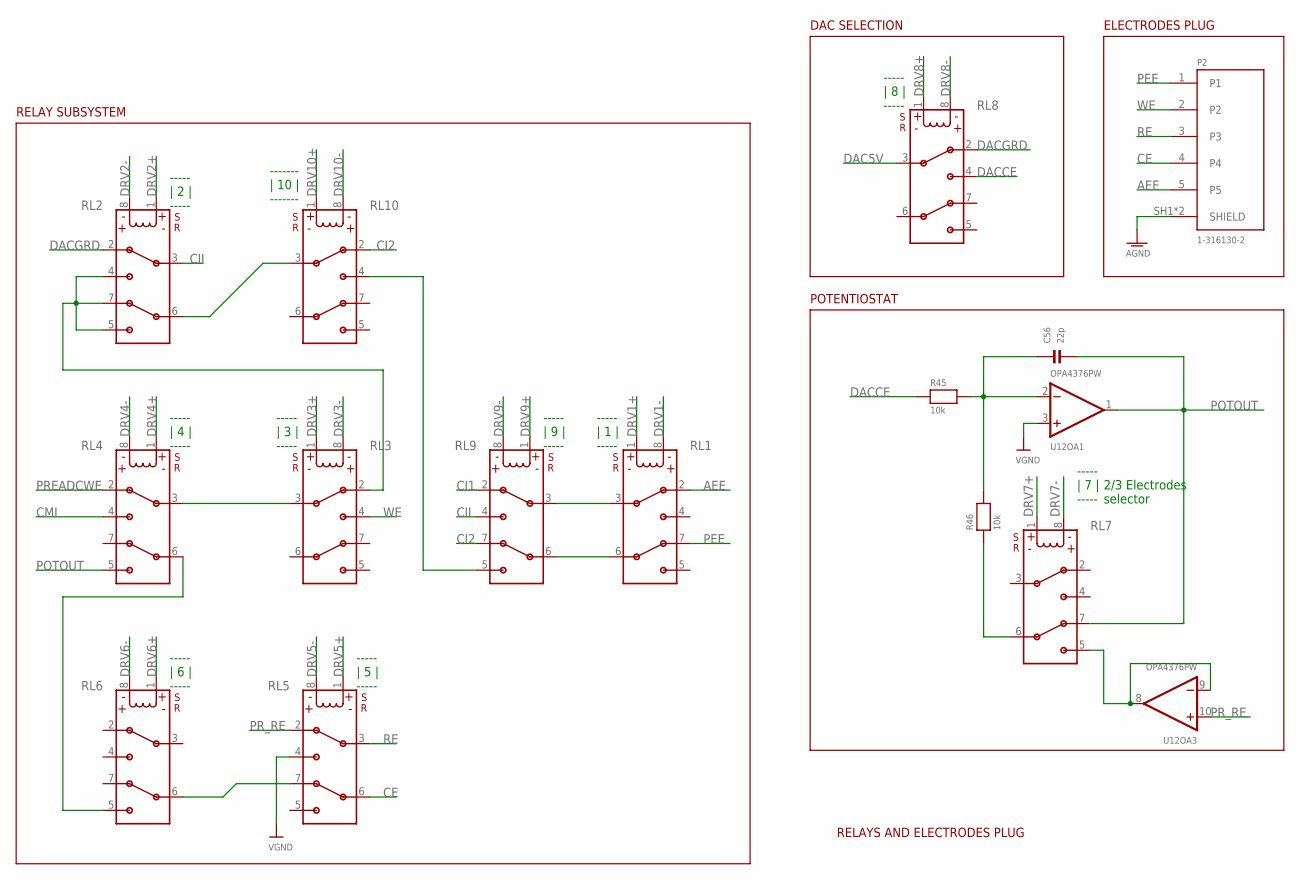
[picture p19: schematic IVEEDRIS-SCIR.sch, sheet 5]

Parts:
C56: 22p; 0805
P2: 1-316130-2; TE_1-316130-2
R45, R46: 10k; 0805
RL1, RL2, RL3, RL4, RL5, RL6, RL7, RL8, RL9, RL10: G6KU-2F-Y
U12: OPA4376PW; TSSOP14-NOTHERMALPAD

Connections:
AEE: P2.5, RL1.2
AGND: P2.SH1 (SHIELD), P2.SH2 (SHIELD); also elsewhere on the board
CE: P2.4, RL5.6
CI1: RL9.2; also elsewhere on the board
CI2: RL9.7, RL10.2; also elsewhere on the board
CII: RL2.3, RL9.4; also elsewhere on the board
CMI: RL4.4; also elsewhere on the board
DAC5V: RL8.3; also elsewhere on the board
DACCE: R45.1, RL8.4
DACGRD: RL2.2, RL8.2
DRV1+: RL1.1 (L+); also elsewhere on the board
DRV1-: RL1.8 (L-); also elsewhere on the board
DRV2+: RL2.1 (L+); also elsewhere on the board
DRV2-: RL2.8 (L-); also elsewhere on the board
DRV3+: RL3.1 (L+); also elsewhere on the board
DRV3-: RL3.8 (L-); also elsewhere on the board
DRV4+: RL4.1 (L+); also elsewhere on the board
DRV4-: RL4.8 (L-); also elsewhere on the board
DRV5+: RL5.1 (L+); also elsewhere on the board
DRV5-: RL5.8 (L-); also elsewhere on the board
DRV6+: RL6.1 (L+); also elsewhere on the board
DRV6-: RL6.8 (L-); also elsewhere on the board
DRV7+: RL7.1 (L+); also elsewhere on the board
DRV7-: RL7.8 (L-); also elsewhere on the board
DRV8+: RL8.1 (L+); also elsewhere on the board
DRV8-: RL8.8 (L-); also elsewhere on the board
DRV9+: RL9.1 (L+); also elsewhere on the board
DRV9-: RL9.8 (L-); also elsewhere on the board
DRV10+: RL10.1 (L+); also elsewhere on the board
DRV10-: RL10.8 (L-); also elsewhere on the board
unnamed: RL5.7, RL6.6
unnamed: RL2.6, RL10.3
unnamed: RL1.3, RL9.3
unnamed: RL1.6, RL9.6
unnamed: RL9.5, RL10.4
unnamed: RL2.4, RL2.5, RL2.7, RL3.2
unnamed: RL4.6, RL6.5
unnamed: RL3.3, RL4.3
unnamed: C56.1, R45.2, R46.2, U12.2 (-IN)
PEE: P2.1, RL1.7
POTOUT: C56.2, RL4.5, RL7.7, U12.1 (OUT); also elsewhere on the board
PREADCCE: R46.1, RL7.6
PREADCRE: RL7.5, U12.8 (OUT), U12.9 (-IN)
PREADCWE: RL4.2; also elsewhere on the board
PR_RE: RL5.2, U12.10 (+IN)
RE: P2.3, RL5.3
VGND: RL5.4, U12.3 (+IN); also elsewhere on the board
WE: P2.2, RL3.4

Notes on the sheet:
2/3 Electrodes selector
----- | 7 | -----
----- | 6 | -----
----- | 4 | -----
----- | 2 | -----
----- | 1 | -----
----- | 3 | -----
----- | 5 | -----
----- | 8 | -----
----- | 9 | -----
------- | 10 | -------
RELAY SUBSYSTEM
DAC SELECTION
ELECTRODES PLUG
POTENTIOSTAT
RELAYS AND ELECTRODES PLUG
