JMonrealT/IVESDRIS/Stimulator - Hardware/IVEEDRIS-SCIR.brd

## EAGLE design Stimulator - Hardware/IVEEDRIS-SCIR.brd (continued)

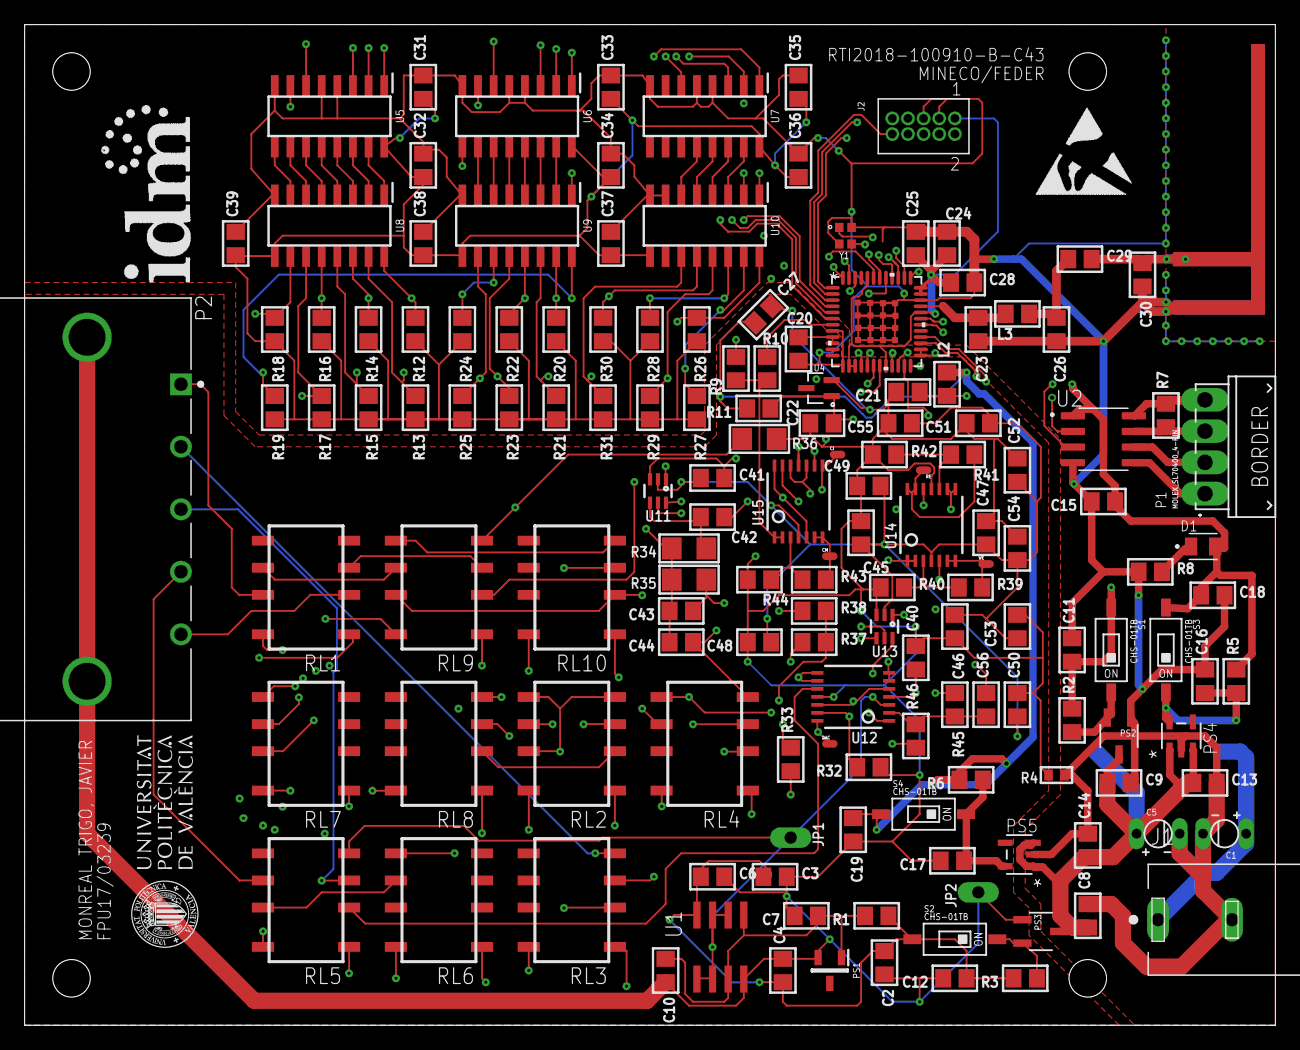
[picture p20: board IVEEDRIS-SCIR.brd from above]

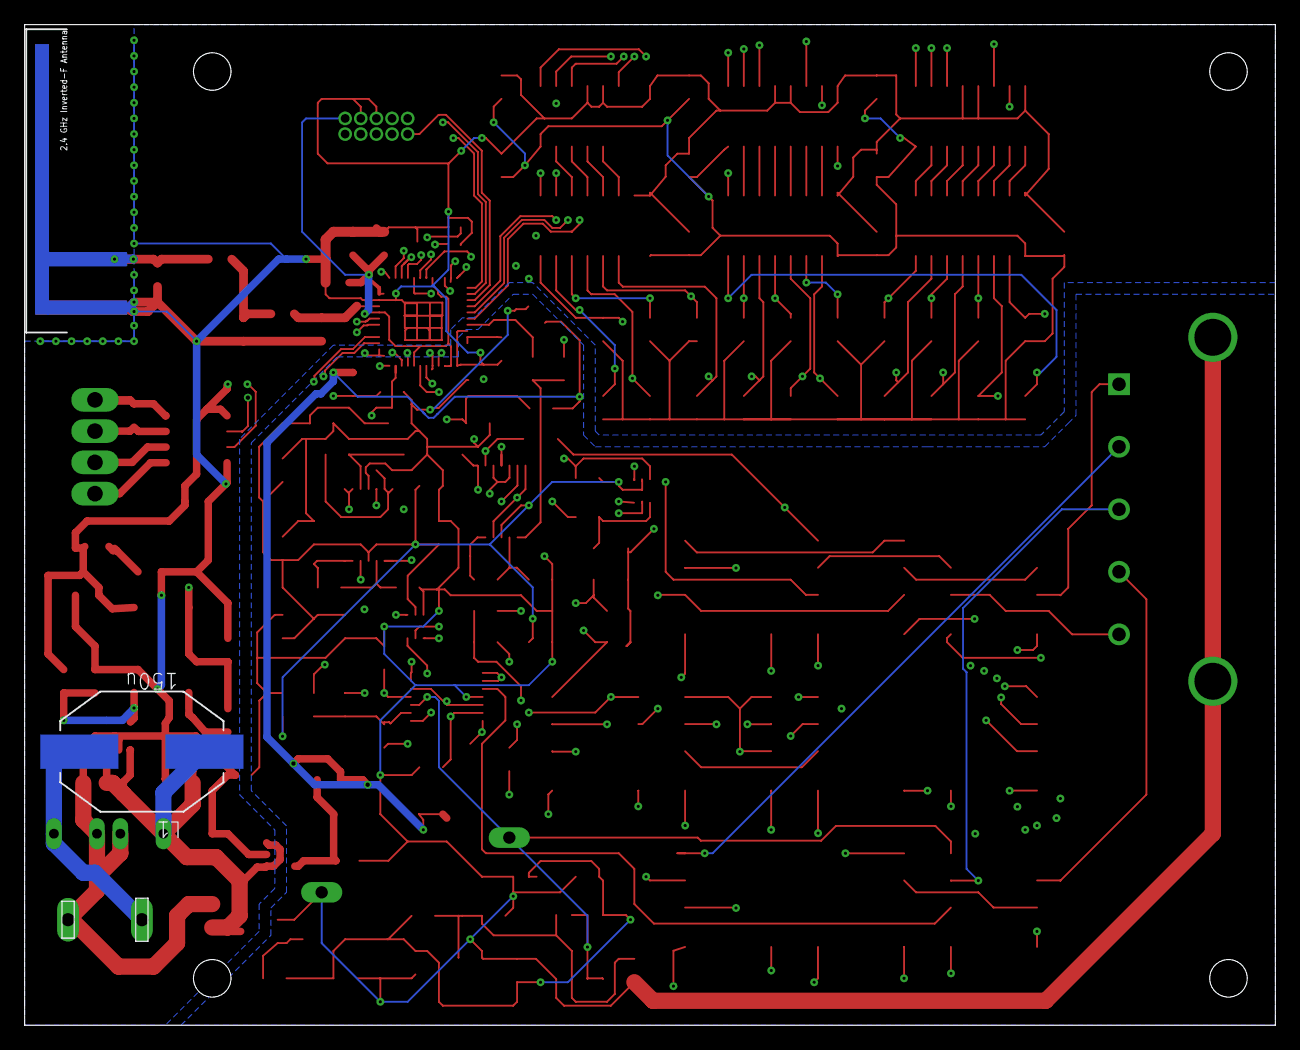
[picture p21: board IVEEDRIS-SCIR.brd from below]

Board: 4 copper layers, 101.6 x 81.3 mm, 153 parts (2 on the bottom side), 131 nets.
