JMonrealT/IVESDRIS/(commit log)

2023-02-21 CC BY-NC-SA LICENSE
    CC BY-NC-SA
    This license allows reusers to distribute, remix, adapt, and build upon the material in any medium or format for noncommercial purposes only, and only so long as attribution is given to the creator. If you remix, adapt, or build upon the material, you must license the modified material under identical terms.
    For commercial permissions contact: jmonreal@upv.es
2024-09-23 Files added
    [Base.SLDPRT, Basev2.SLDPRT, Basev2.STL, BoM IVEEDRIS-SCIR.xlsx, CapsEnclosure.SLDPRT, CapsEnclosure.STL, CommunicationsConnectorBox.SLDPRT, CommunicationsConnectorBox.STL]
